stuartpittaway/diyBMSv4/TemperaturePCB/TemperaturePCB.kicad_pcb

## KiCad design TemperaturePCB/TemperaturePCB.kicad_pcb (2025-04-18)

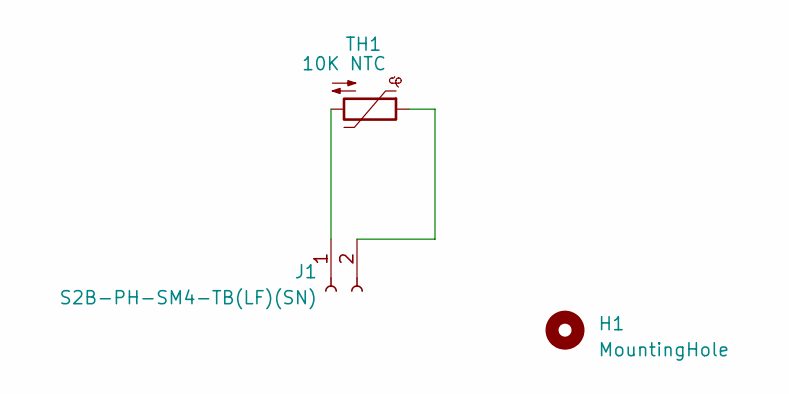
[picture p1: schematic TemperaturePCB.kicad_sch]

Parts:
H1: MountingHole; MountingHole_6.5mm_Pad_Via
J1: S2B-PH-SM4-TB(LF)(SN); JST_PH_S2B-PH-SM4-TB_1x02-1MP_P2.00mm_Horizontal; LCSCStockCode C295747
TH1: 10K NTC; R_0805_2012Metric; PartNumber CMFB103F3950FANT; LCSCStockCode C51597

Connections:
unnamed: J1.1, TH1.2
unnamed: J1.2, TH1.1

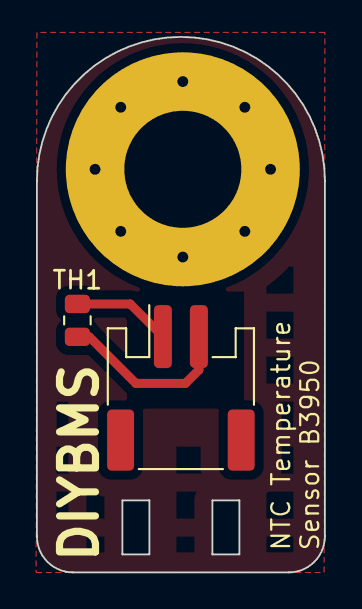
[picture p2: board TemperaturePCB.kicad_pcb from above]

Board: 2 copper layers, 16.0 x 29.8 mm, 3 parts (0 on the bottom side), 2 nets.
