stuartpittaway/diyBMSv4/ModuleV490-PassiveBal/Module_16S_PassiveBalanceAddOn.kicad_pcb

## KiCad design ModuleV490-PassiveBal/Module_16S_PassiveBalanceAddOn.kicad_pcb (2025-04-18)

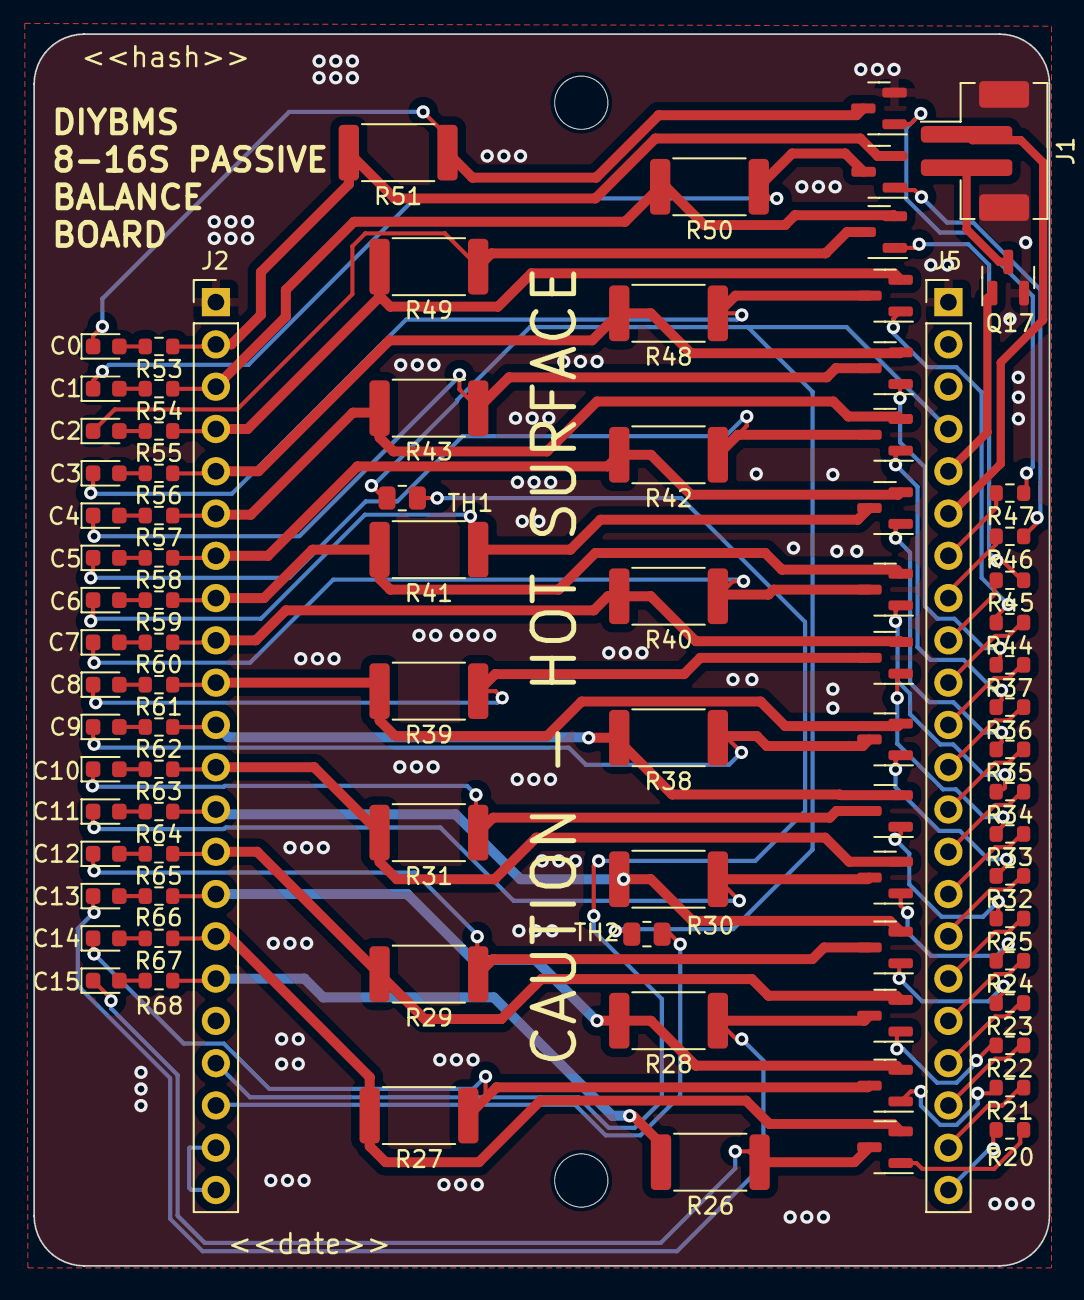
[picture p3: board Module_16S_PassiveBalanceAddOn.kicad_pcb from above]

Board: 2 copper layers, 61.0 x 74.0 mm, 89 parts (1 on the bottom side), 88 nets.

Parts:
C0, C1, C2, C3, C4, C5, C6, C7, C8, C9, C10, C11, C12, C13, C14, C15: Yellow; LED_0603_1608Metric
G2: DIYBMS_LOGO; diybms_logo_24x10mm
H1, H2: MountingHole; MountingHole_3.2mm_M3
J1: FAN_12V; JST_PH_B2B-PH-SM4-TB_1x02-1MP_P2.00mm_Vertical
J2, J5: 22PIN; PinHeader_1x22_P2.54mm_Vertical
Q1, Q2, Q3, Q4, Q5, Q6, Q7, Q8, Q9, Q10, Q11, Q12, Q13, Q14, Q15, Q16: AO3400A; SOT-23
Q17: SZNUD3160; SOT-23
R20, R21, R22, R23, R24, R25, R32, R33, R34, R35, R36, R37, R44, R45, R46, R47: 100R; R_0603_1608Metric
R26, R27, R28, R29, R30, R31, R38, R39, R40, R41, R42, R43, R48, R49, R50, R51: 18R 2W; R_2512_6332Metric
R53, R54, R55, R56, R57, R58, R59, R60, R61, R62, R63, R64, R65, R66, R67, R68: 330R; R_0603_1608Metric
TH1, TH2: 10K NTC; R_0805_2012Metric

Connections:
+3.3V: J2.21, J2.22
BA1: J5.7, R47.1
BA2: J5.8, R46.1
BA3: J5.9, R45.1
BA4: J5.10, R44.1
BA5: J5.11, R37.1
BA6: J5.12, R36.1
BA7: J5.13, R35.1
BA8: J5.14, R34.1
BA9: J5.15, R33.1
BA10: J5.16, R32.1
BA11: J5.17, R25.1
BA12: J5.18, R24.1
BA13: J5.19, R23.1
BA14: J5.20, R22.1
BA15: J5.21, R21.1
BA16: J5.22, R20.1
CV1: J2.2, Q15.2 (S), R51.2, R53.1
CV2: J2.3, Q14.2 (S), R50.2, R54.1
CV3: J2.4, Q13.2 (S), R49.2, R55.1
CV4: J2.5, Q12.2 (S), R48.2, R56.1
CV5: J2.6, Q11.2 (S), R43.2, R57.1
CV6: J2.7, Q10.2 (S), R42.2, R58.1
CV7: J2.8, Q9.2 (S), R41.2, R59.1
CV8: J2.9, Q8.2 (S), R40.2, R60.1
CV9: J2.10, Q7.2 (S), R39.2, R61.1
CV10: J2.11, Q6.2 (S), R38.2, R62.1
CV11: J2.12, Q5.2 (S), R31.2, R63.1
CV12: J2.13, Q4.2 (S), R30.2, R64.1
CV13: J2.14, Q3.2 (S), R29.2, R65.1
CV14: J2.15, Q2.2 (S), R28.2, R66.1
CV15: J2.16, Q1.2 (S), R27.2, R67.1
CV16: J2.17, R26.2, R68.1
FAN: J5.5, Q17.1 (G)
GND: J1.MP, J2.1, J5.1, Q16.2 (S), Q17.2 (S)
unnamed: C0.2 (A), R53.2
unnamed: C0.1 (K), Q16.3 (D), R51.1
unnamed: C1.2 (A), R54.2
unnamed: C1.1 (K), Q15.3 (D), R50.1
unnamed: C2.2 (A), R55.2
unnamed: C2.1 (K), Q14.3 (D), R49.1
unnamed: C3.2 (A), R56.2
unnamed: C3.1 (K), Q13.3 (D), R48.1
unnamed: C4.2 (A), R57.2
unnamed: C4.1 (K), Q12.3 (D), R43.1
unnamed: C5.2 (A), R58.2
unnamed: C5.1 (K), Q11.3 (D), R42.1
unnamed: C6.2 (A), R59.2
unnamed: C6.1 (K), Q10.3 (D), R41.1
unnamed: C7.2 (A), R60.2
unnamed: C7.1 (K), Q9.3 (D), R40.1
unnamed: C8.2 (A), R61.2
unnamed: C8.1 (K), Q8.3 (D), R39.1
unnamed: C9.2 (A), R62.2
unnamed: C9.1 (K), Q7.3 (D), R38.1
unnamed: C10.2 (A), R63.2
unnamed: C10.1 (K), Q6.3 (D), R31.1
unnamed: C11.2 (A), R64.2
unnamed: C11.1 (K), Q5.3 (D), R30.1
unnamed: C12.2 (A), R65.2
unnamed: C12.1 (K), Q4.3 (D), R29.1
unnamed: C13.2 (A), R66.2
unnamed: C13.1 (K), Q3.3 (D), R28.1
unnamed: C14.2 (A), R67.2
unnamed: C14.1 (K), Q2.3 (D), R27.1
unnamed: C15.2 (A), R68.2
unnamed: C15.1 (K), Q1.3 (D), R26.1
unnamed: J1.2, Q17.3 (D)
unnamed: Q1.1 (G), R20.2
unnamed: Q2.1 (G), R21.2
unnamed: Q3.1 (G), R22.2
unnamed: Q4.1 (G), R23.2
unnamed: Q5.1 (G), R24.2
unnamed: Q6.1 (G), R25.2
unnamed: Q7.1 (G), R32.2
unnamed: Q8.1 (G), R33.2
unnamed: Q9.1 (G), R34.2
unnamed: Q10.1 (G), R35.2
unnamed: Q11.1 (G), R36.2
unnamed: Q12.1 (G), R37.2
unnamed: Q13.1 (G), R44.2
unnamed: Q14.1 (G), R45.2
unnamed: Q15.1 (G), R46.2
unnamed: Q16.1 (G), R47.2
STEP_DOWN_V: J1.1, J5.6
T1: J2.19, TH1.2
T2: J2.20, TH2.2
TH_ENABLE: J5.4, TH1.1, TH2.1
