stuartpittaway/diyBMSv4/ControllerCurrentShuntAddOn/ControllerCurrentShuntAddOn.kicad_pcb

## KiCad design ControllerCurrentShuntAddOn/ControllerCurrentShuntAddOn.kicad_pcb (2023-03-01)

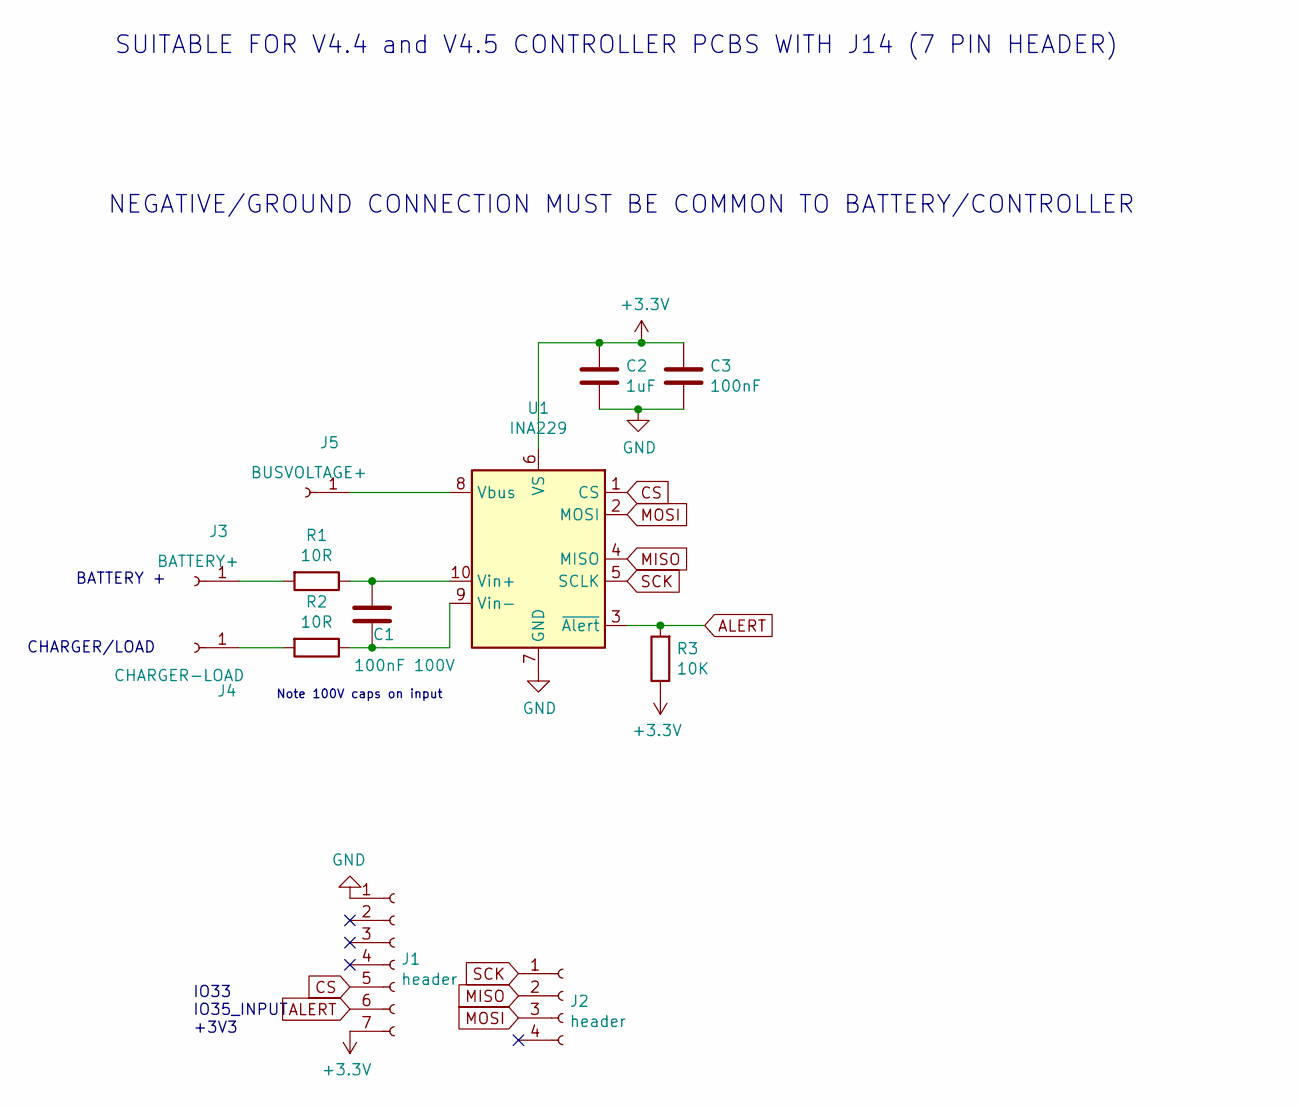
[picture p6: schematic ControllerCurrentShuntAddOn.sch, DIYBMS CONTROLLER CURRENT SHUNT DAUGHTER CARD]

Parts:
C1: 100nF 100V; C_0805_2012Metric; PartNumber C0805C104K1RECAUTO; LCSCStockCode C696367
C2: 1uF; C_0805_2012Metric; PartNumber CL21B105KBFNNNE; LCSCStockCode C28323
C3: 100nF; C_0805_2012Metric; PartNumber CC0805KRX7R9BB104; LCSCStockCode C49678
J1: header; PinHeader_1x07_P2.54mm_Vertical
J2: header; PinHeader_1x04_P2.54mm_Vertical
J3: BATTERY+; TestPoint_Pad_D4.0mm
J4: CHARGER-LOAD; TestPoint_Pad_D4.0mm
J5: BUSVOLTAGE+; TestPoint_Pad_D4.0mm
R1, R2: 10R; R_0805_2012Metric; PartNumber 0805W8F100JT5E; LCSCStockCode C17415
R3: 10K; R_0805_2012Metric; PartNumber 0805W8F1002T5E; LCSCStockCode C17414
U1: INA229; VSSOP-10_3x3mm_P0.5mm; PartNumber INA229AIDGSR; LCSCStockCode C2846803

Connections:
+3V3: C2.1, C3.1, J1.7, R3.1, U1.6 (VS)
ALERT: J1.6, R3.2, U1.3 (~Alert~)
CS: J1.5, U1.1 (CS)
GND: C2.2, C3.2, J1.1, U1.7 (GND)
MISO: J2.2, U1.4 (MISO)
MOSI: J2.3, U1.2 (MOSI)
unnamed: C1.1, R1.1, U1.10 (Vin+)
unnamed: C1.2, R2.1, U1.9 (Vin-)
unnamed: J3.1, R1.2
unnamed: J4.1, R2.2
unnamed: J5.1, U1.8 (Vbus)
SCK: J2.1, U1.5 (SCLK)

Notes on the sheet:
Note 100V caps on input
BATTERY +
CHARGER/LOAD
NEGATIVE/GROUND CONNECTION MUST BE COMMON TO BATTERY/CONTROLLER
SUITABLE FOR V4.4 and V4.5 CONTROLLER PCBS WITH J14 (7 PIN HEADER)
IO33 IO35_INPUT +3V3

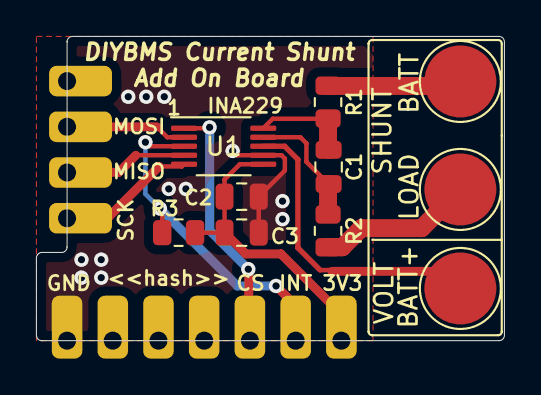
[picture p7: board ControllerCurrentShuntAddOn.kicad_pcb from above]

Board: 2 copper layers, 26.0 x 16.9 mm, 12 parts (0 on the bottom side), 12 nets.
