stuartpittaway/diyBMSv4/ModuleV450/ModuleV450.kicad_pcb

## KiCad design ModuleV450/ModuleV450.kicad_pcb (2022-12-26)

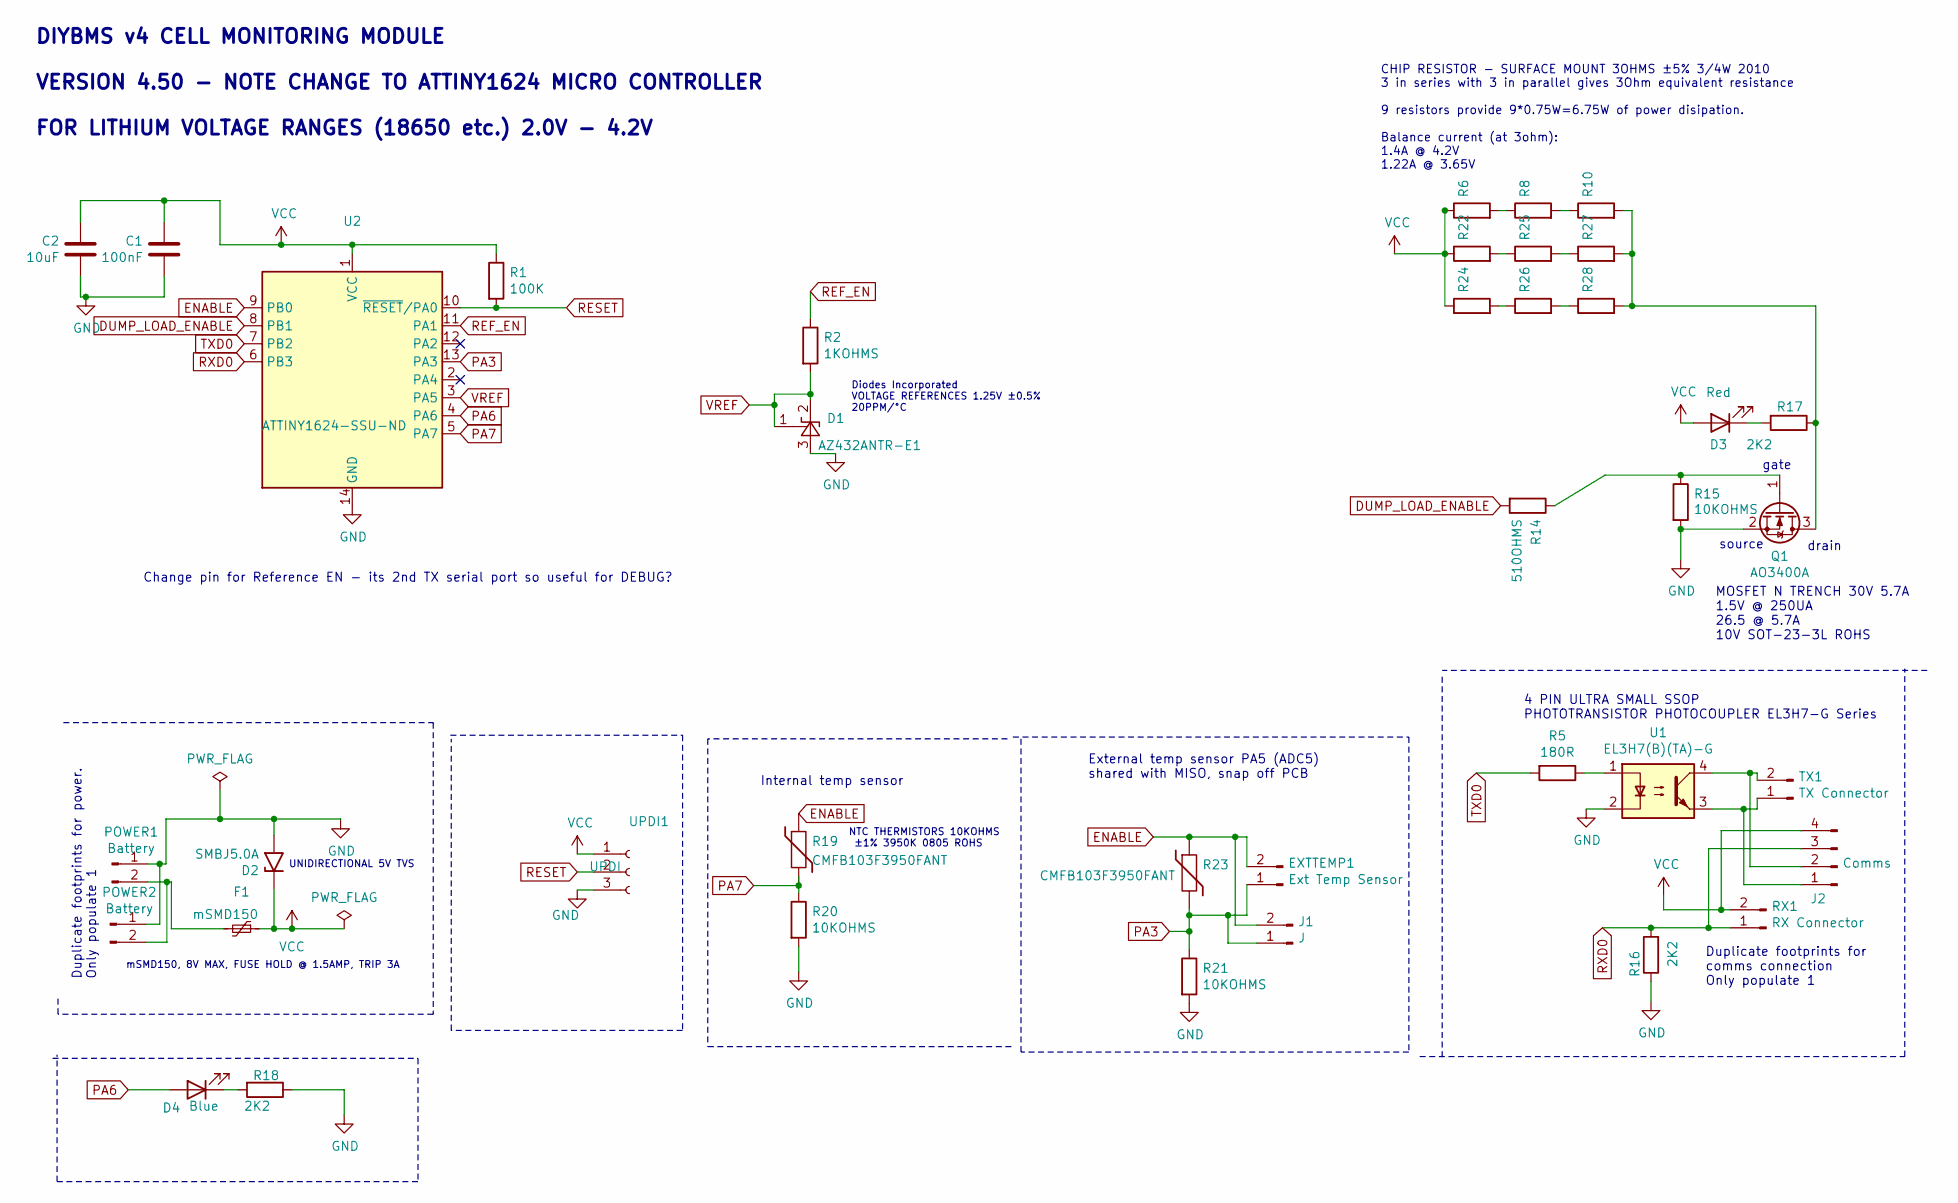
[picture p8: schematic ModuleV450.sch, DIYBMS cell monitoring module]

Parts:
C1: 100nF; C_0805_2012Metric; PartNumber CC0805KRX7R9BB104; LCSCStockCode C49678
C2: 10uF; C_0805_2012Metric; PartNumber CL21A106KAYNNNE; LCSCStockCode C15850
D1: AZ432ANTR-E1; SOT-23; PartNumber AZ432ANTR-E1; LCSCStockCode C84139
D2: SMBJ5.0A; D_SMB; LCSCStockCode C440263
D3: Red; LED_0805_2012Metric; PartNumber NCD0805R1; LCSCStockCode C84256
D4: Blue; LED_0603_1608Metric; PartNumber 19-217/GHC-YR1S2/3T; LCSCStockCode C72043
EXTTEMP1: Ext Temp Sensor; JST_PH_S2B-PH-K_1x02_P2.00mm_Horizontal; PartNumber S2B-PH-K(LF)(SN); LCSCStockCode C265016
F1: mSMD150; Fuse_1812_4532Metric; PartNumber mSMD150; LCSCStockCode C70121
J1: J; PinSocket_1x02_P2.54mm_Vertical
J2: Comms; PhoenixContact_MC_1,5_4-G-3.81_1x04_P3.81mm_Horizontal; LCSCStockCode C265016
POWER1: Battery; JST_PH_S2B-PH-K_1x02_P2.00mm_Horizontal; PartNumber S2B-PH-K(LF)(SN); LCSCStockCode C265016
POWER2: Battery; PhoenixContact_MC_1,5_2-G-3.81_1x02_P3.81mm_Horizontal; PartNumber S2B-PH-K(LF)(SN); LCSCStockCode C265016
Q1: AO3400A; SOT-23; PartNumber AO3400A; LCSCStockCode C347475
R1: 100K; R_0805_2012Metric; PartNumber 0805W8F1003T5E; LCSCStockCode C149504
R2: 1KOHMS; R_0805_2012Metric; PartNumber 0805W8F1001T5E; LCSCStockCode C17513
R5: 180R; R_0805_2012Metric; PartNumber 0805W8F1800T5E; LCSCStockCode C25270
R6, R8, R10, R22, R24, R25, R26, R27, R28: 3R; R_2010_5025Metric; PartNumber 201007J030JT4E; LCSCStockCode C474300
R14: 510OHMS; R_0805_2012Metric; PartNumber 0805W8F5100T5E; LCSCStockCode C17734
R15, R20, R21: 10KOHMS; R_0805_2012Metric; PartNumber 0805W8F1002T5E; LCSCStockCode C17414
R16, R17, R18: 2K2; R_0805_2012Metric; PartNumber 0805W8F2201T5E; LCSCStockCode C17520
R19, R23: CMFB103F3950FANT; R_0805_2012Metric; PartNumber CMFB103F3950FANT; LCSCStockCode C51597
RX1: RX Connector; JST_PH_S2B-PH-K_1x02_P2.00mm_Horizontal; PartNumber S2B-PH-K(LF)(SN); LCSCStockCode C265016
TX1: TX Connector; JST_PH_S2B-PH-K_1x02_P2.00mm_Horizontal; PartNumber S2B-PH-K(LF)(SN); LCSCStockCode C265016
U1: EL3H7(B)(TA)-G; SOP-4_4.4x2.6mm_P1.27mm; PartNumber EL3H7(B)(TA)-G; LCSCStockCode C32565
U2: ATTINY1624-SSU-ND; SOIC-14_3.9x8.7mm_P1.27mm; PartNumber ATTINY1624-SSU-ND; LCSCStockCode C3237666
UPDI1: UPDI; PinSocket_1x03_P2.54mm_Vertical

Connections:
DUMP_LOAD_ENABLE: R14.2, U2.8 (PB1)
ENABLE: EXTTEMP1.2, J1.2, R19.1, R23.1, U2.9 (PB0)
GND: C1.2, C2.2, D1.3 (A), D2.2 (A2), POWER1.1, POWER2.1, Q1.2 (S), R15.2, R16.1, R18.1, R20.2, R21.2, U1.2, U2.14 (GND), UPDI1.3
unnamed: D3.1 (K), R17.2
unnamed: D4.1 (K), R18.2
unnamed: F1.2, POWER1.2, POWER2.2
unnamed: J2.1, TX1.1, U1.3
unnamed: J2.2, TX1.2, U1.4
unnamed: Q1.1 (G), R14.1, R15.1
unnamed: Q1.3 (D), R10.2, R17.1, R27.2, R28.2
unnamed: R5.1, U1.1
unnamed: R6.2, R8.1
unnamed: R8.2, R10.1
unnamed: R22.2, R25.1
unnamed: R24.2, R26.1
unnamed: R25.2, R27.1
unnamed: R26.2, R28.1
PA3: EXTTEMP1.1, J1.1, R21.1, R23.2, U2.13 (PA3)
PA6: D4.2 (A), U2.4 (PA6)
PA7: R19.2, R20.1, U2.5 (PA7)
REF_EN: R2.1, U2.11 (PA1)
RESET: R1.2, U2.10 (~RESET~/PA0), UPDI1.2
RXD0: J2.3, R16.2, RX1.1, U2.6 (PB3)
TXD0: R5.2, U2.7 (PB2)
VCC: C1.1, C2.1, D2.1 (A1), D3.2 (A), F1.1, J2.4, R1.1, R6.1, R22.1, R24.1, RX1.2, U2.1 (VCC), UPDI1.1
VREF: D1.1 (FB), D1.2 (K), R2.2, U2.3 (PA5)

Notes on the sheet:
CHIP RESISTOR - SURFACE MOUNT 3OHMS ±5% 3/4W 2010 3 in series with 3 in parallel gives 3Ohm equivalent resistance 9 resistors provide 9*0.75W=6.75W of power disipation. Balance current (at 3ohm): 1.4A @ 4.2V 1.22A @ 3.65V
gate
source
drain
4 PIN ULTRA SMALL SSOP PHOTOTRANSISTOR PHOTOCOUPLER EL3H7-G Series
MOSFET N TRENCH 30V 5.7A 1.5V @ 250UA 26.5 @ 5.7A 10V SOT-23-3L ROHS
mSMD150, 8V MAX, FUSE HOLD @ 1.5AMP, TRIP 3A
External temp sensor PA5 (ADC5) shared with MISO, snap off PCB
NTC THERMISTORS 10KOHMS ±1% 3950K 0805 ROHS
DIYBMS v4 CELL MONITORING MODULE VERSION 4.50 - NOTE CHANGE TO ATTINY1624 MICRO CONTROLLER FOR LITHIUM VOLTAGE RANGES (18650 etc.) 2.0V - 4.2V
Internal temp sensor
UNIDIRECTIONAL 5V TVS
Diodes Incorporated VOLTAGE REFERENCES 1.25V ±0.5% 20PPM/°C
Change pin for Reference EN - its 2nd TX serial port so useful for DEBUG?
Duplicate footprints for comms connection Only populate 1
Duplicate footprints for power. Only populate 1

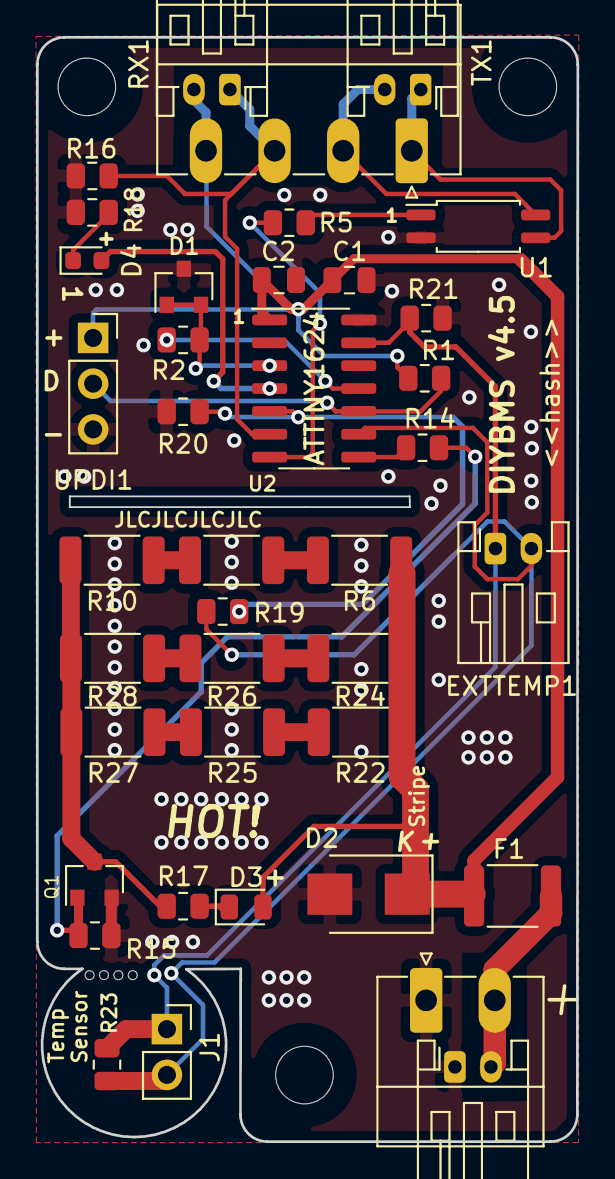
[picture p9: board ModuleV450.kicad_pcb from above]

Board: 2 copper layers, 30.0 x 61.3 mm, 39 parts (0 on the bottom side), 26 nets.
