stuartpittaway/diyBMSv4/ProgrammingAdapter/ProgrammingAdapter.kicad_pcb

## KiCad design ProgrammingAdapter/ProgrammingAdapter.kicad_pcb (2021-03-11)

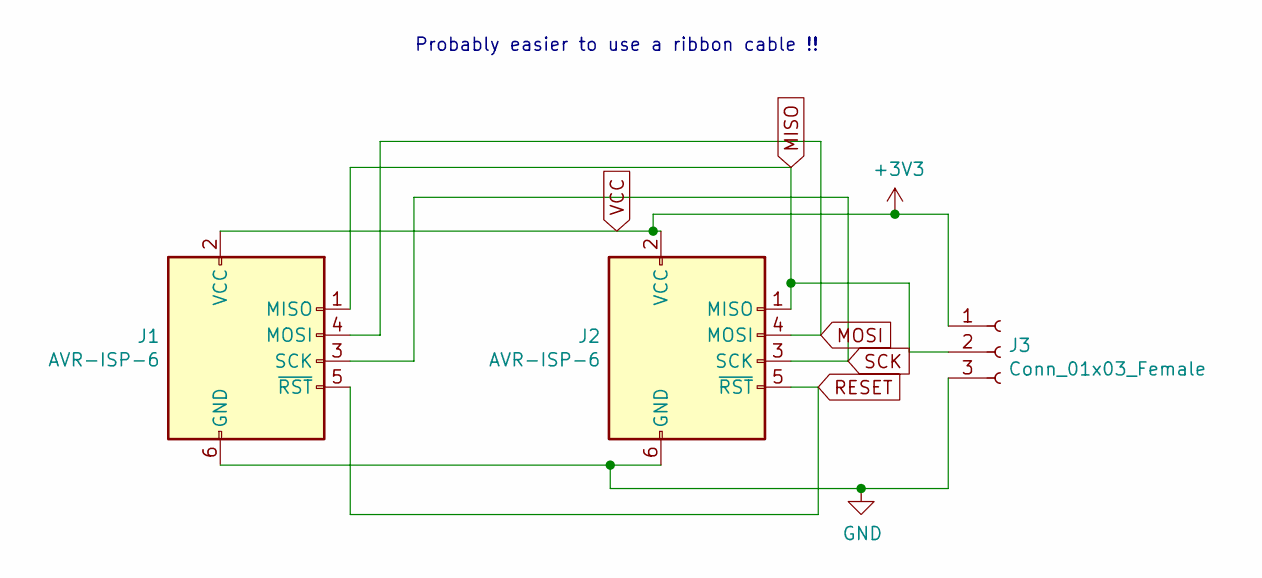
[picture p12: schematic ProgrammingAdapter.sch, DIYBMS ISP Programmer Adapter]

Parts:
J1, J2: AVR-ISP-6; PinSocket_2x03_P2.54mm_Vertical; LCSCStockCode C124421
J3: Conn_01x03_Female; PinSocket_1x03_P2.54mm_Vertical; LCSCStockCode C225500

Connections:
GND: J1.6 (GND), J2.6 (GND), J3.3
MISO: J1.1 (MISO), J2.1 (MISO), J3.2
MOSI: J1.4 (MOSI), J2.4 (MOSI)
RESET: J1.5 (~RST), J2.5 (~RST)
SCK: J1.3 (SCK), J2.3 (SCK)
VCC: J1.2 (VCC), J2.2 (VCC), J3.1

Notes on the sheet:
Probably easier to use a ribbon cable !!

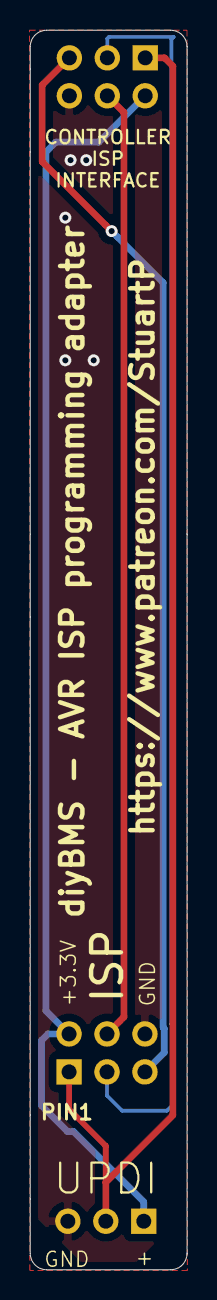
[picture p13: board ProgrammingAdapter.kicad_pcb from above]

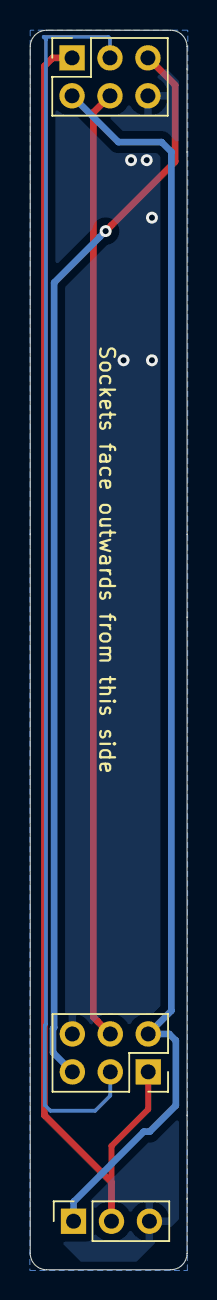
[picture p14: board ProgrammingAdapter.kicad_pcb from below]

Board: 2 copper layers, 10.5 x 83.0 mm, 3 parts (3 on the bottom side), 6 nets.
