stuartpittaway/diyBMSv4/ESP8266ControllerCircuit/ESP8266ControllerCircuit.kicad_pcb

## KiCad design ESP8266ControllerCircuit/ESP8266ControllerCircuit.kicad_pcb (2021-03-08)

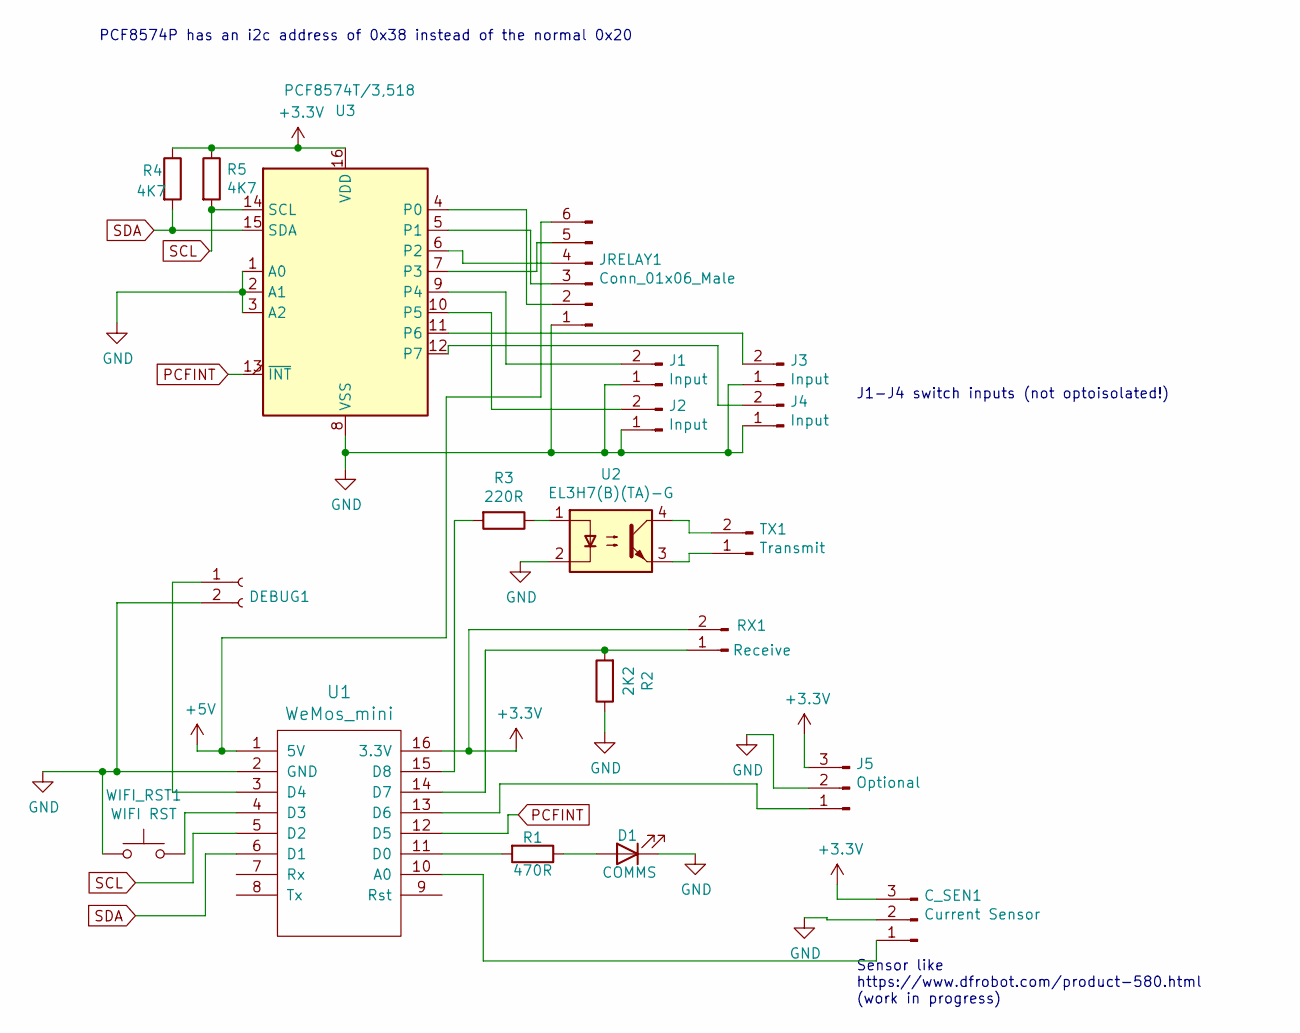
[picture p15: schematic ESP8266ControllerCircuit.sch, diyBMS ESP8266 Controller [legacy]

Parts:
C_SEN1: Current Sensor; Pin_Header_Straight_1x03_Pitch2.54mm
D1: COMMS; LED_0805; PartNumber Hubei KENTO Elec Green 0805; LCSCStockCode C2297
DEBUG1: Conn_01x02_Female; Pin_Header_Straight_1x02_Pitch2.54mm
J1, J2, J3, J4: Input; JST_PH_S2B-PH-K_02x2.00mm_Angled
J5: Optional; Pin_Header_Straight_1x03_Pitch2.54mm
JRELAY1: Conn_01x06_Male; Pin_Header_Straight_1x06_Pitch2.54mm
R1: 470R; R_0805_HandSoldering; PartNumber 0805W8F4700T5E; LCSCStockCode C17710
R2: 2K2; R_0805_HandSoldering; PartNumber 0805W8F2201T5E; LCSCStockCode C17520
R3: 220R; R_0805_HandSoldering; PartNumber 0805W8F2200T5E; LCSCStockCode C17557
R4, R5: 4K7; R_0805_HandSoldering; PartNumber 0805W8F4701T5E; LCSCStockCode C17673
RX1: Receive; JST_PH_S2B-PH-K_02x2.00mm_Angled
TX1: Transmit; JST_PH_S2B-PH-K_02x2.00mm_Angled
U1: WeMos_mini; wemos-d1-mini-with-pin-header
U2: EL3H7(B)(TA)-G; SOP-4_4.4x2.8mm_Pitch1.27mm; LCSCStockCode C32565
U3: PCF8574T/3,518; SOIC-16W_7.5x10.3mm_Pitch1.27mm; PartNumber PCF8574T/3,518; LCSCStockCode C7605
WIFI_RST1: WIFI RST; Pin_Header_Straight_1x02_Pitch2.54mm

Connections:
+3V3: C_SEN1.3, J5.3, R4.1, R5.1, RX1.2, U1.16 (3.3V), U3.16 (VDD)
+5V: JRELAY1.6, U1.1 (5V)
GND: C_SEN1.2, D1.1 (K), DEBUG1.2, J1.1, J2.1, J3.1, J4.1, J5.2, JRELAY1.1, R2.1, U1.2 (GND), U2.2, U3.1 (A0), U3.2 (A1), U3.3 (A2), U3.8 (VSS), WIFI_RST1.1
unnamed: C_SEN1.1, U1.10 (A0)
unnamed: D1.2 (A), R1.1
unnamed: DEBUG1.1, U1.3 (D4)
unnamed: J1.2, U3.9 (P4)
unnamed: J2.2, U3.10 (P5)
unnamed: J3.2, U3.11 (P6)
unnamed: J4.2, U3.12 (P7)
unnamed: J5.1, U1.13 (D6)
unnamed: JRELAY1.2, U3.4 (P0)
unnamed: JRELAY1.3, U3.5 (P1)
unnamed: JRELAY1.4, U3.6 (P2)
unnamed: JRELAY1.5, U3.7 (P3)
unnamed: R1.2, U1.11 (D0)
unnamed: R2.2, RX1.1, U1.14 (D7)
unnamed: R3.1, U2.1
unnamed: R3.2, U1.15 (D8)
unnamed: TX1.1, U2.3
unnamed: TX1.2, U2.4
unnamed: U1.4 (D3), WIFI_RST1.2
PCFINT: U1.12 (D5), U3.13 (~INT~)
SCL: R5.2, U1.5 (D2), U3.14 (SCL)
SDA: R4.2, U1.6 (D1), U3.15 (SDA)

Notes on the sheet:
PCF8574P has an i2c address of 0x38 instead of the normal 0x20
Sensor like https://www.dfrobot.com/product-580.html (work in progress)
J1-J4 switch inputs (not optoisolated!)

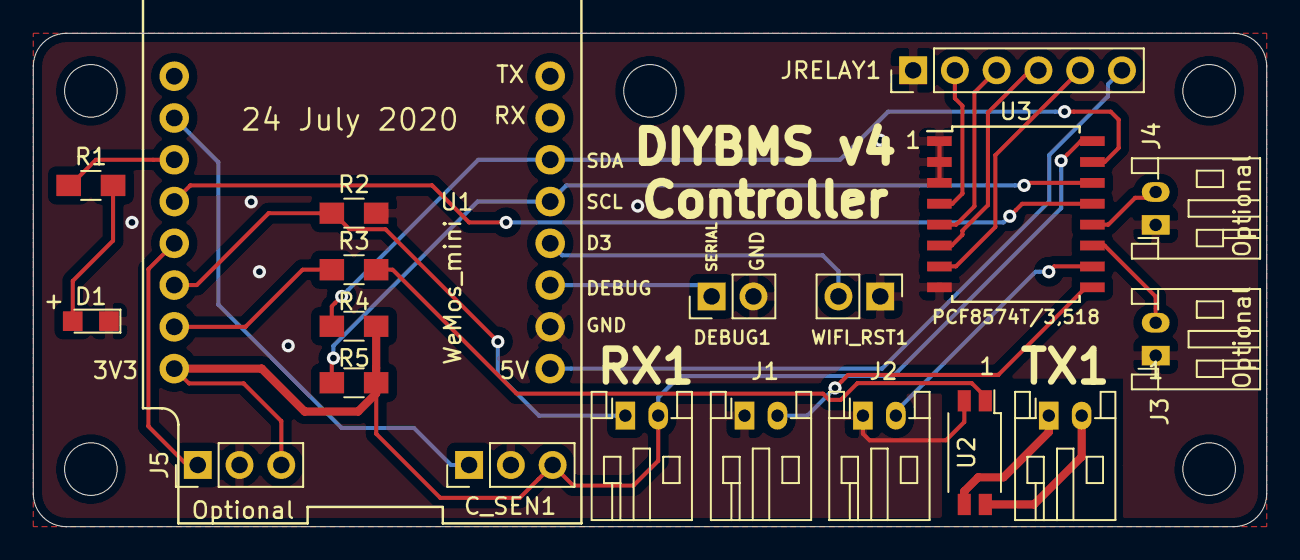
[picture p16: board ESP8266ControllerCircuit.kicad_pcb from above]

Board: 2 copper layers, 75.0 x 30.0 mm, 20 parts (0 on the bottom side), 25 nets.
