stuartpittaway/diyBMSv4/ModuleV400/v4.kicad_pcb

## KiCad design ModuleV400/v4.kicad_pcb (2020-03-15, an earlier design)

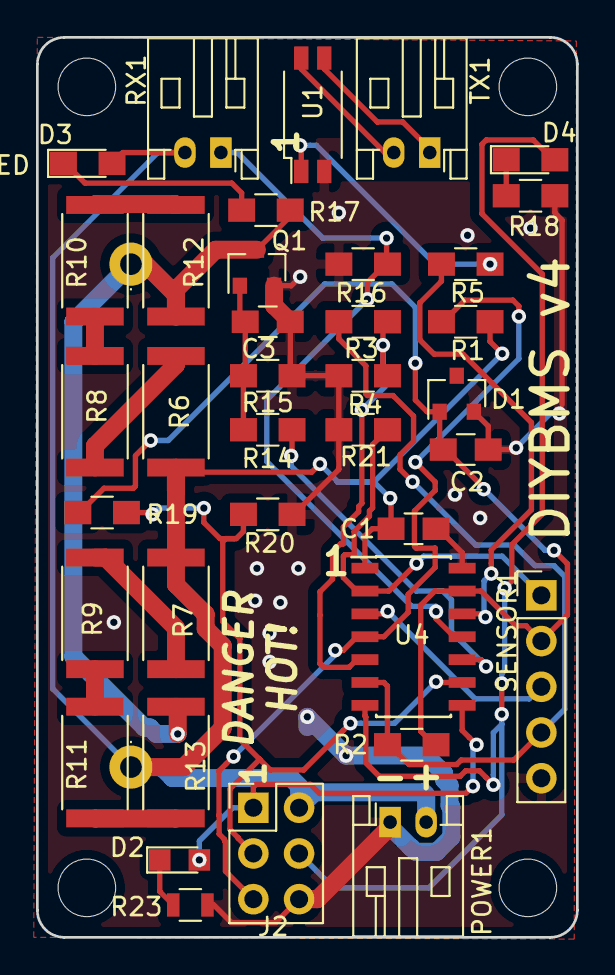
[picture p17: board v4.kicad_pcb from above]

Board: 2 copper layers, 30.0 x 50.0 mm, 38 parts (0 on the bottom side), 28 nets.

Parts:
C1: 100nF; C_0805_HandSoldering
C2: 2.2uF; C_0805_HandSoldering
C3: 10uF 10V; C_0805_HandSoldering
D1: LM4040BIM3-2.0/NOPB, 2.048V, SOT-23-3; SOT-23
D2: Blue; LED_0805
D3: RED LED; LED_0805_HandSoldering
D4: Green; LED_0805_HandSoldering
J2: AVR-ISP-6; Pin_Header_Straight_2x03_Pitch2.54mm
POWER1: Battery; JST_PH_S2B-PH-K_02x2.00mm_Angled
Q1: IRLML6244TRPBF; SOT-23
R1: 10K; R_0805_HandSoldering
R2: 1K; R_0805_HandSoldering
R3: 475K E96 series (tolerance 1%); R_0805_HandSoldering
R4: 402K E96 series (tolerance 1%); R_0805_HandSoldering
R5: 220R; R_0805_HandSoldering
R6, R7, R8, R9, R10, R11, R12, R13: 2R2 1W; R_2512
R14: 510R; R_0805_HandSoldering
R15, R20, R21: 47K; R_0805_HandSoldering
R16: 4K7; R_0805_HandSoldering
R17, R18: 2K2; R_0805_HandSoldering
R19: SDNT2012X473F4150FTF; R_0805_HandSoldering
R22: 10R; R_Axial_Power_L25.0mm_W9.0mm_P27.94mm
R23: 2K2; R_0805
RX1: RX Connector; JST_PH_S2B-PH-K_02x2.00mm_Angled
SENSOR1: Remote temp input 47K @ 25oC; Pin_Header_Straight_1x05_Pitch2.54mm
TX1: TX Connector; JST_PH_S2B-PH-K_02x2.00mm_Angled
U1: HMHA2801; SOP-4_4.4x2.8mm_Pitch1.27mm
U4: ATtiny841-SSU; SOIC-14_3.9x8.7mm_Pitch1.27mm

Connections:
2_VOLT: C2.1, D1.1, R2.2, R19.1, SENSOR1.2, U4.13
DUMP_LOAD_ENABLE: R14.2, U4.10
ENABLE: R2.1, R3.1, SENSOR1.4, U4.6
GND: C1.2, C2.2, C3.2, D1.2, J2.6, POWER1.1, Q1.2, R4.2, R15.2, R16.1, R18.1, R20.2, R21.2, R23.1, SENSOR1.5, U1.2, U4.14
unnamed: C3.1, Q1.1, R14.1, R15.1
unnamed: D2.1, R23.2
unnamed: D3.1, R17.2
unnamed: D4.1, R18.2
unnamed: D4.2, J2.4, U4.7
unnamed: J2.5, R1.2, U4.4
unnamed: Q1.3, R12.2, R13.2, R17.1, R22.1
unnamed: R3.2, R4.1, U4.5
unnamed: R5.1, U1.1
unnamed: R6.2, R8.1
unnamed: R7.2, R9.1
unnamed: R8.2, R10.1
unnamed: R10.2, R12.1
unnamed: R9.2, R11.1
unnamed: R11.2, R13.1
unnamed: R21.1, SENSOR1.1, U4.2
unnamed: SENSOR1.3, U4.3
unnamed: TX1.1, U1.3
unnamed: TX1.2, U1.4
RXD0: R16.2, RX1.1, U4.11
RXD1: J2.3, R19.2, R20.1, U4.9
TXD0: R5.2, U4.12
TXD1: D2.2, J2.1, U4.8
VCC: C1.1, D3.2, J2.2, POWER1.2, R1.1, R6.1, R7.1, R22.2, RX1.2, U4.1
