stuartpittaway/diyBMSv4/(notices)

Notices in the files:
ControllerCircuit/ControllerCircuit.kicad_pcb:
©2019 to 2024 Stuart Pittaway
ModuleV490-PassiveBal/Module_16S_PassiveBalanceAddOn.kicad_pcb:
©2023-2024 Stuart Pittaway
ModuleV440/ModuleV440.kicad_pcb:
©2019-2021
ModuleV421/ModuleV421.kicad_pcb:
©2019/2020 Stuart Pittaway
ModuleV400/v4.kicad_pcb:
©2019 Stuart Pittaway
ModuleV450/ModuleV450.kicad_pcb:
©2019-2022
